BleuLlama/LlamaVideoSwitcher/Schematic/Schematic_1.4.pdf

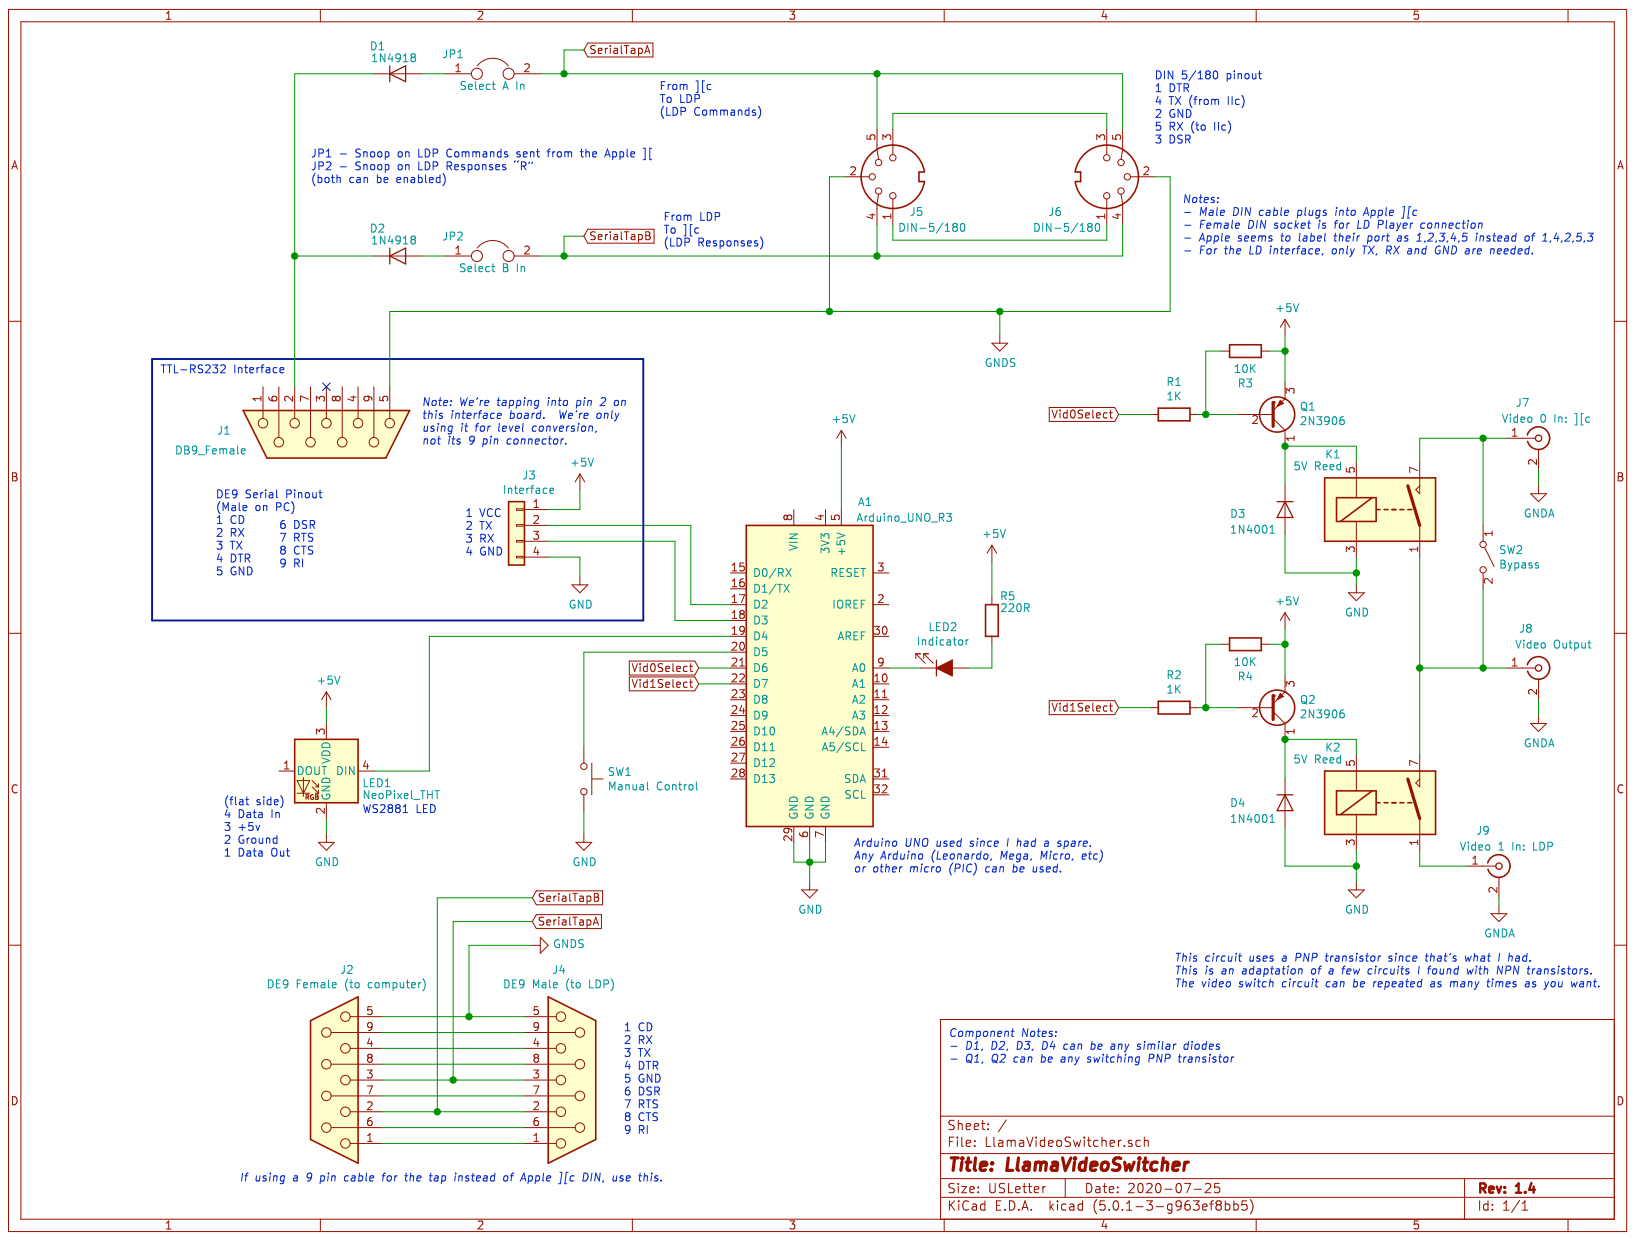
[picture p1: page 1]
