BleuLlama/LlamaVideoSwitcher/Schematic/Schematic_1.3.pdf

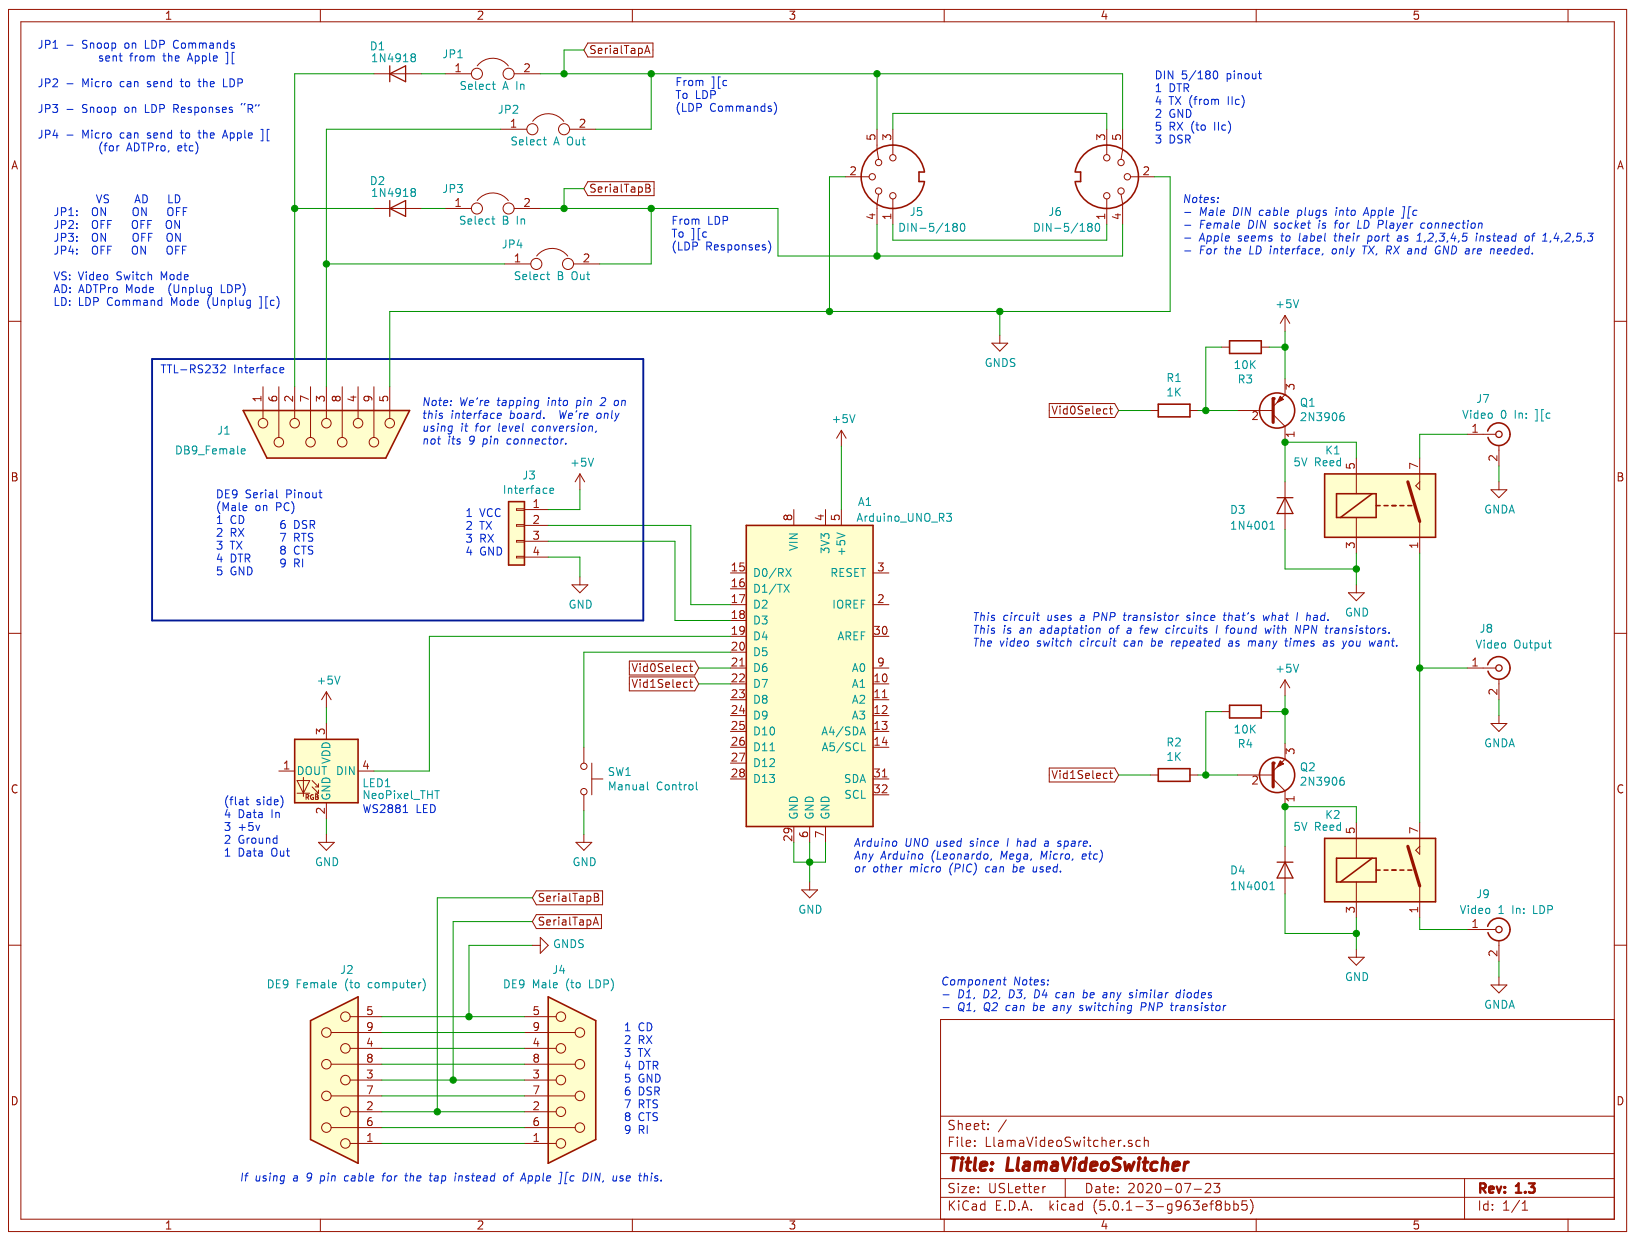
[picture p2: page 1]
