BleuLlama/LlamaVideoSwitcher/Schematic/Schematic_1.2.pdf

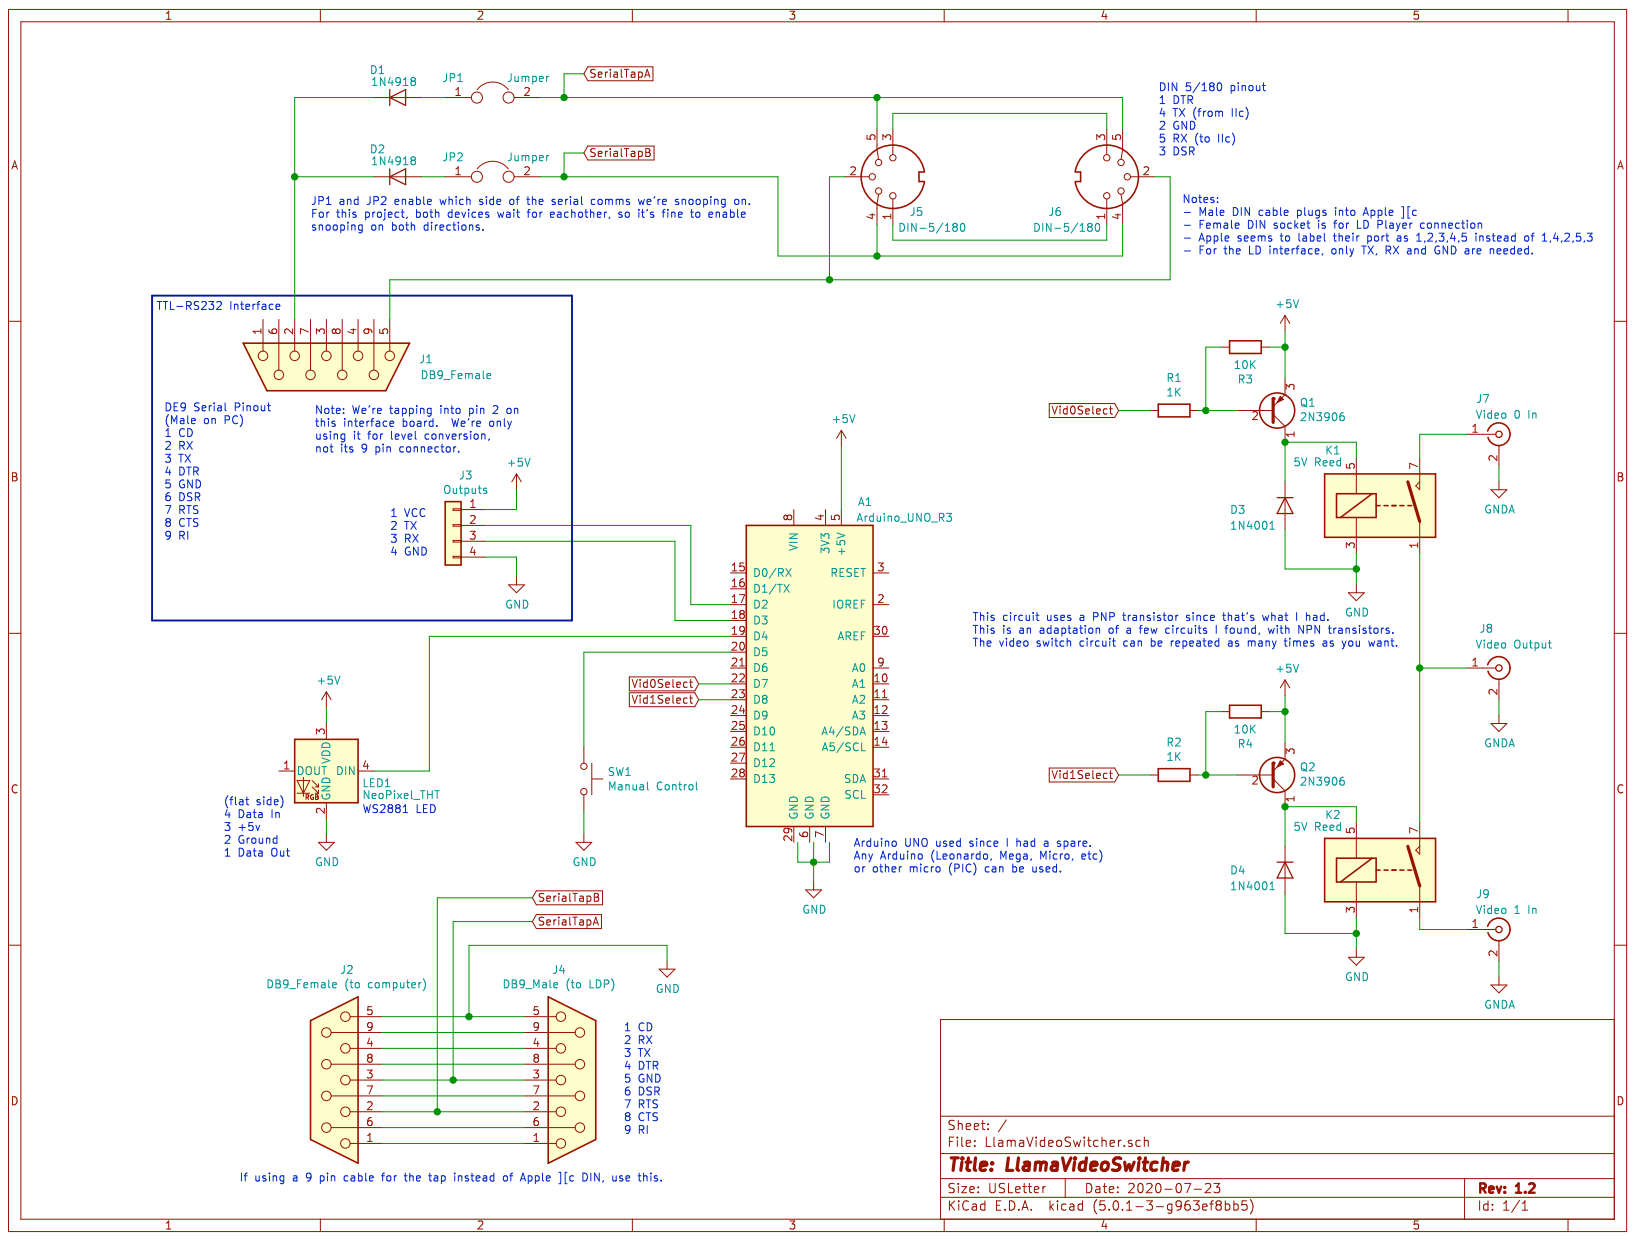
[picture p3: page 1]
