BleuLlama/LlamaVideoSwitcher/Schematic/Schematic_1.1.pdf

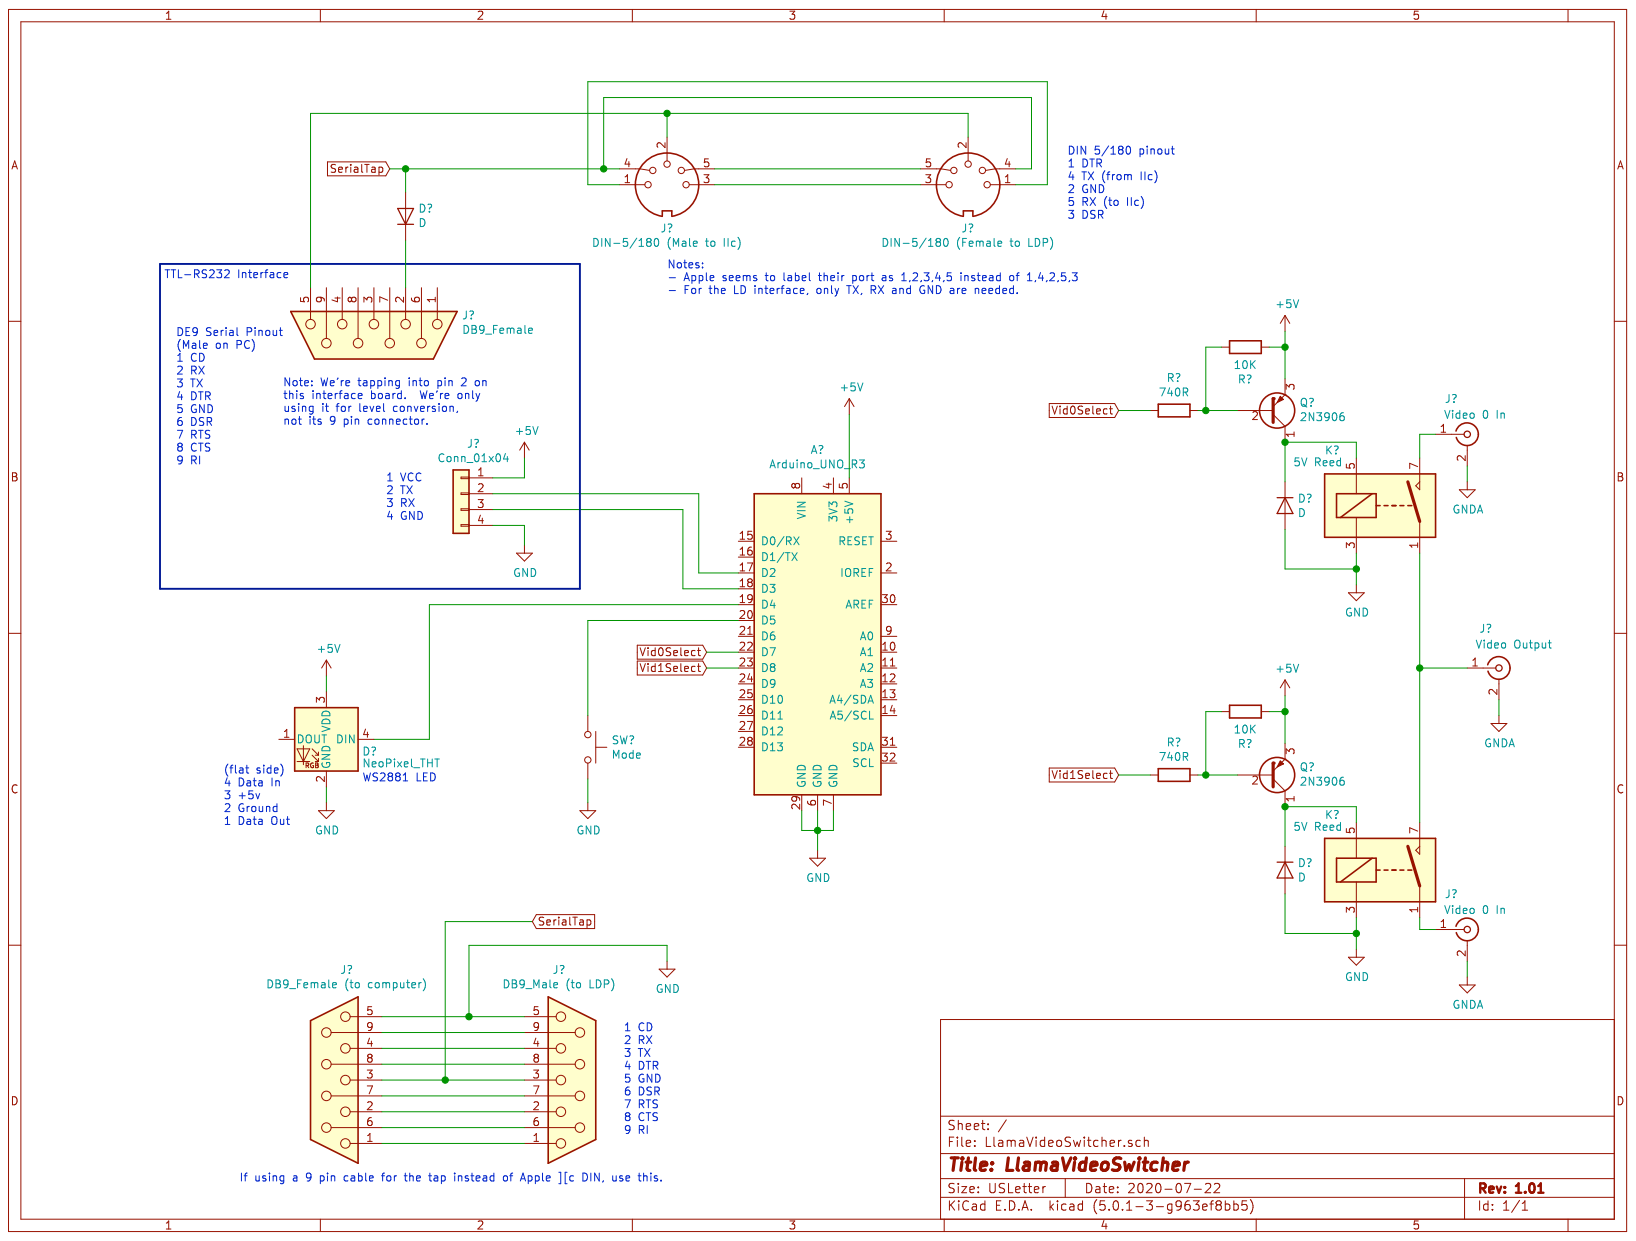
[picture p4: page 1]
