BleuLlama/LlamaVideoSwitcher/Schematic/Schematic_1.0.pdf

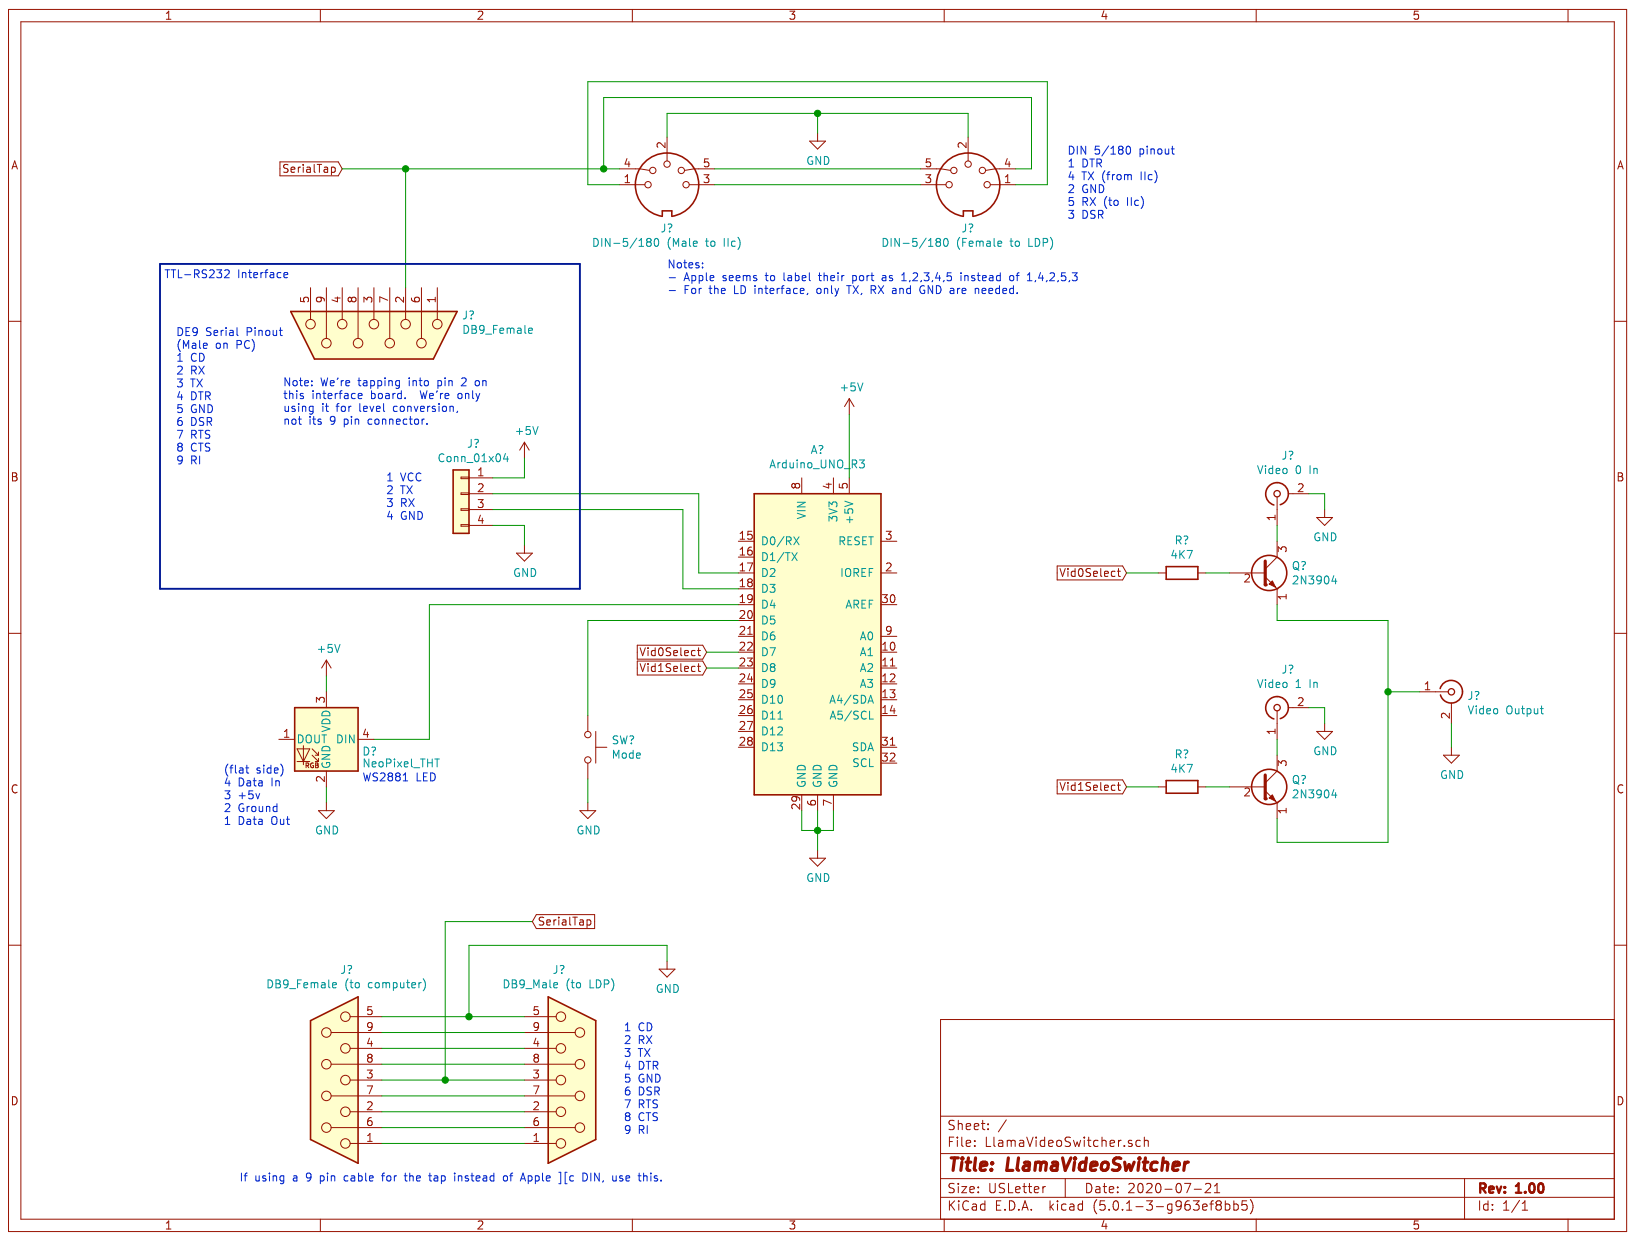
[picture p5: page 1]
