BleuLlama/LlamaVideoSwitcher/Schematic/LlamaVideoSwitcher/LlamaVideoSwitcher.kicad_pcb

## KiCad design USB2Serial.sch

Schematic: USB2Serial.sch

Parts:
C3: 5uF
P1: USB_OTG
U3: CP2104--USB/UART_BRIDGE
