BleuLlama/LlamaVideoSwitcher/(commit log)

2020-07-22 Interim checkin
    [LlamaVideoSwitcher.kicad_pcb, LlamaVideoSwitcher.sch]
2020-07-22 Updated for design fixes
    [LlamaVideoSwitcher.sch]
2020-07-23 Updated schematic to the final, working version.
    [LlamaVideoSwitcher.sch]
2020-07-23 Updated to the current somewhat working version.
2020-07-23 Updated to the latest versions of everything
    [LlamaVideoSwitcher.sch]
2020-07-25 Added flashing single standard LED
2020-07-25 Final(ish) version - Current working version.
    [LlamaVideoSwitcher.sch]
